SensitivePen/Shield_CapacitiveTouch/Electronics/MovuinoShieldCapacitiveTouch/part-lib/FH12-10S-0.5SH_55_/FH12-10S-0.5SH_55_.step

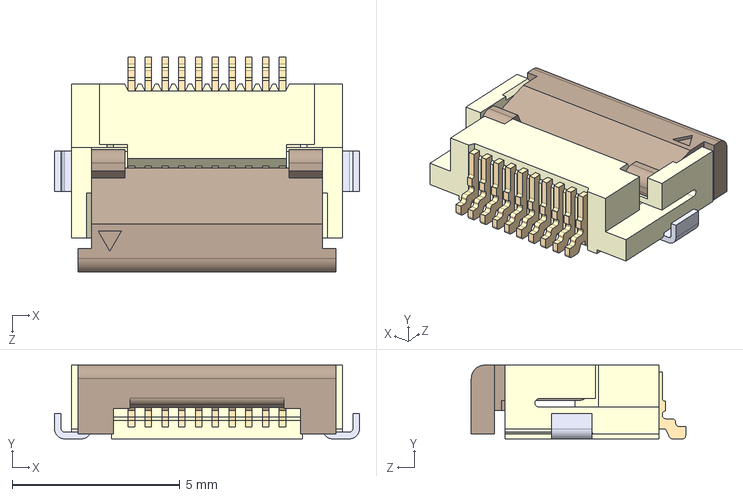
[picture p2: CAD file, 2022-04-13]
Electronics/MovuinoShieldCapacitiveTouch/part-lib/FH12-10S-0.5SH_55_/FH12-10S-0.5SH_55_.step
9.10 x 2.20 x 6.40 mm
