SensitivePen/Shield_CapacitiveTouch/Electronics/MovuinoShieldCapacitiveTouch/MovuinoShieldCapacitiveTouch.kicad_pcb

## KiCad design Electronics/MovuinoShieldCapacitiveTouch/MovuinoShieldCapacitiveTouch.kicad_pcb (2022-04-13)

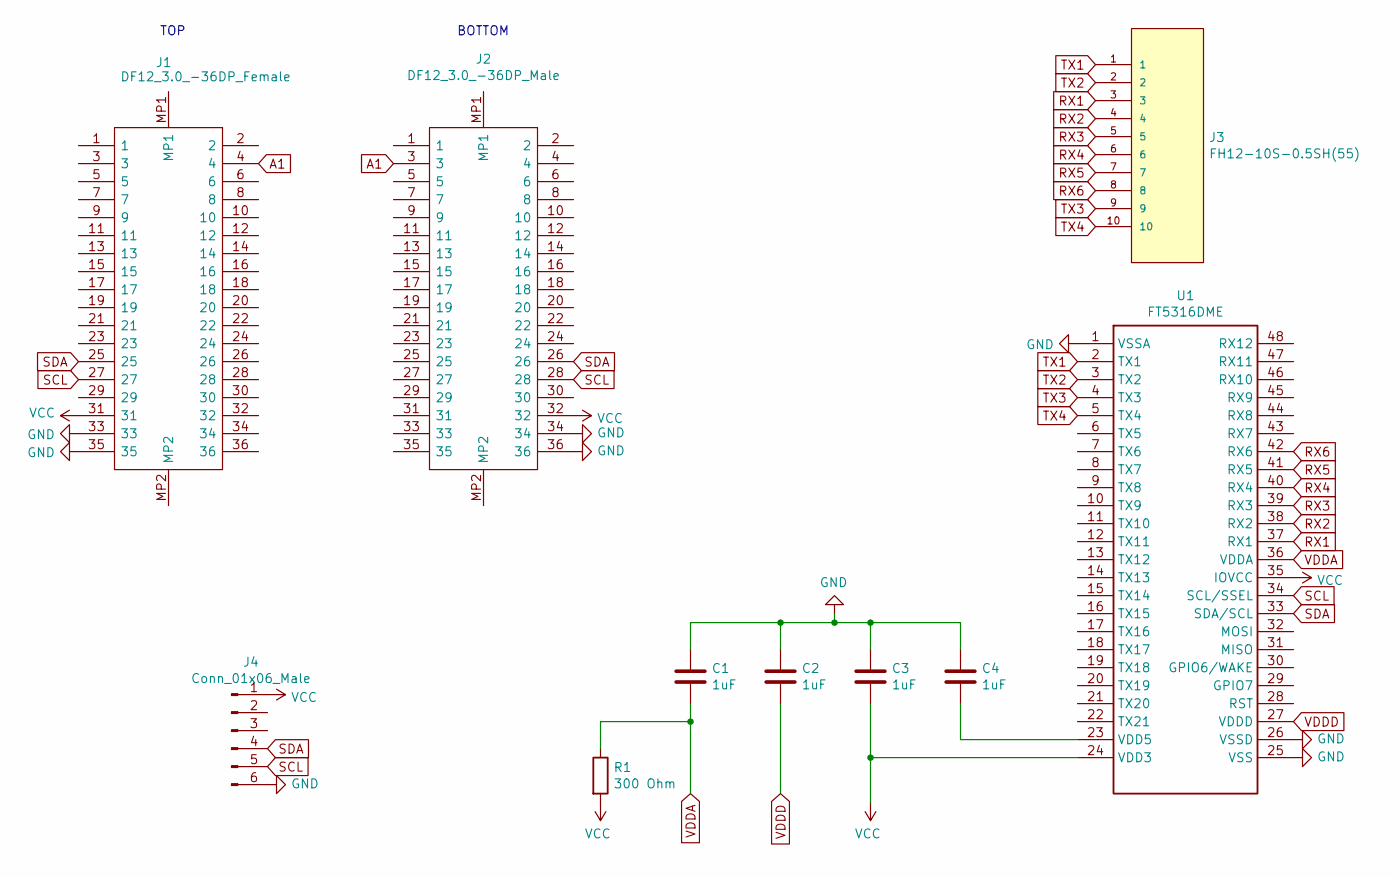
[picture p3: schematic MovuinoShieldCapacitiveTouch.sch]

Parts:
C1, C2, C3, C4: 1uF; C_0603_1608Metric
J1: DF12_3.0_-36DP_Female; DF123036DP05V86; Mouser Part Number 798-DF123036DP0.5V86
J2: DF12_3.0_-36DP_Male; DF123036DP05V86; Mouser Part Number 798-DF123036DP0.5V86
J3: FH12-10S-0.5SH(55); FH12-10S-0.5SH(55)_HIR; MANUFACTURER_PART_NUMBER FH12-10S-0.5SH(55)
J4: Conn_01x06_Male; PinHeader_1x06_P2.54mm_Vertical
R1: 300 Ohm; R_0603_1608Metric
U1: FT5316DME; QFN40P600X600X60-49N

Connections:
A1: J1.4, J2.3
GND: C1.1, C2.1, C3.1, C4.1, J1.33, J1.35, J2.34, J2.36, J4.6, U1.1 (VSSA), U1.25 (VSS), U1.26 (VSSD), U1.49
unnamed: C4.2, U1.23 (VDD5)
RX1: J3.3, U1.37 (RX1)
RX2: J3.4, U1.38 (RX2)
RX3: J3.5, U1.39 (RX3)
RX4: J3.6, U1.40 (RX4)
RX5: J3.7, U1.41 (RX5)
RX6: J3.8, U1.42 (RX6)
SCL: J1.27, J2.28, J4.5, U1.34 (SCL/SSEL)
SDA: J1.25, J2.26, J4.4, U1.33 (SDA/SCL)
TX1: J3.1, U1.2 (TX1)
TX2: J3.2, U1.3 (TX2)
TX3: J3.9, U1.4 (TX3)
TX4: J3.10, U1.5 (TX4)
VCC: C3.2, J1.31, J2.32, J4.1, R1.2, U1.24 (VDD3), U1.35 (IOVCC)
VDDA: C1.2, R1.1, U1.36 (VDDA)
VDDD: C2.2, U1.27 (VDDD)

Notes on the sheet:
TOP
BOTTOM

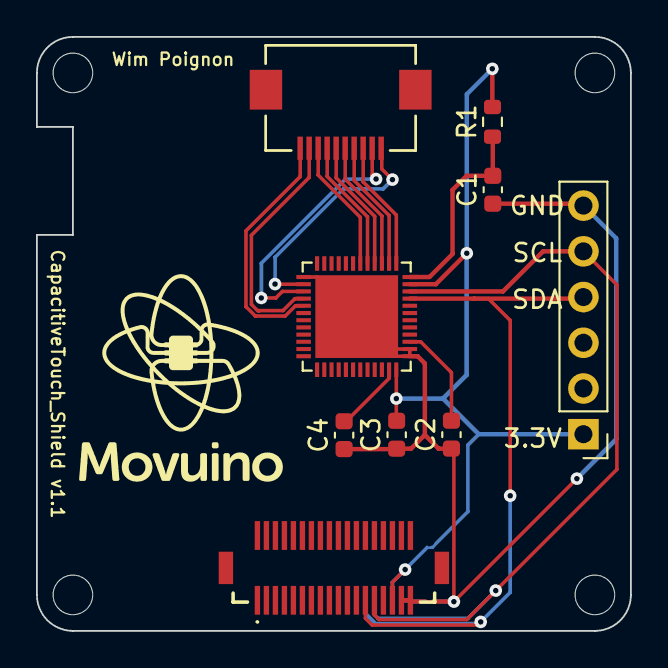
[picture p4: board MovuinoShieldCapacitiveTouch.kicad_pcb from above]

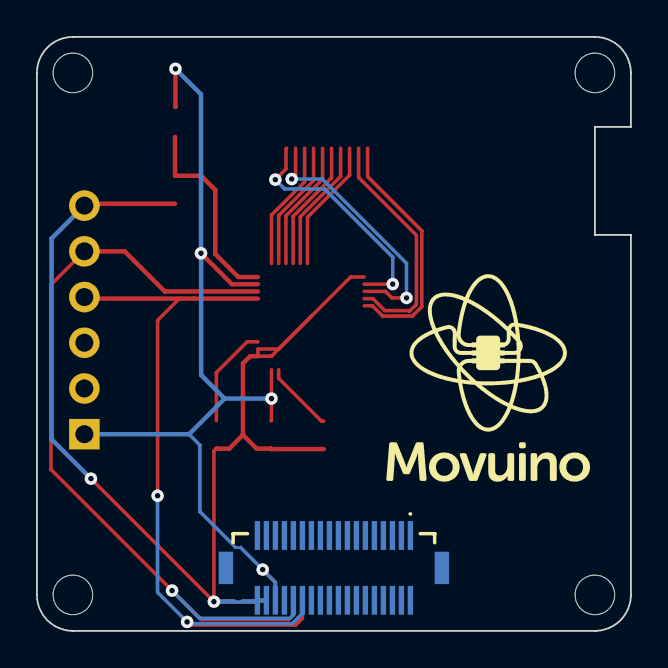
[picture p5: board MovuinoShieldCapacitiveTouch.kicad_pcb from below]

Board: 2 copper layers, 33.0 x 33.0 mm, 12 parts (2 on the bottom side), 18 nets.

Other parts of the board:
U$8, U$8#2: LOGO_MOVUINOBOTTOM_11MM; LOGO_MOVUINO_BMP_11MM-BOTTOM
