SensitivePen/Shield_CapacitiveTouch/(commit log)

2022-04-13 init electronics
    [FH12-10S-0.5SH_55_.step, MovuinoShieldCapacitiveTouch.kicad_pcb, MovuinoShieldCapacitiveTouch.sch, MovuinoShieldCapacitiveTouchDebug.kicad_pcb, MovuinoShieldCapacitiveTouchDebug.sch]
2022-04-13 init CapacitiveTouch_Raw
2022-04-20 init CapacitiveTouch_TouchPoints
2022-04-26 fix(lib): CapacitiveTouch
2022-04-26 fix(lib): CapacitivTouch
    invert rx tx
    [_CapacitiveTouch.h]
2022-04-26 fix: invert rx tx
    [CapacitiveTouch_Raw.ino]
2022-05-05 fix(lib): SDA/SCL ESP32
