SensitivePen/Shield_CapacitiveTouch/(notices)

Notices in the files:
parts and their libraries:
Copyright (C) 2018 Accelerated Designs. All rights reserved
